shriharivish/Biomon_Photoplethysmography/README.md

# Biomon_Photoplethysmography
Design of the control circuit for the osram biomon sfh 7050 for optical photoplethysmography

For more insight about the project, the design and understanding what was done and why see the PDF named as final report.
