shriharivish/Biomon_Photoplethysmography/Plots/Bandpass1Hz.PNG

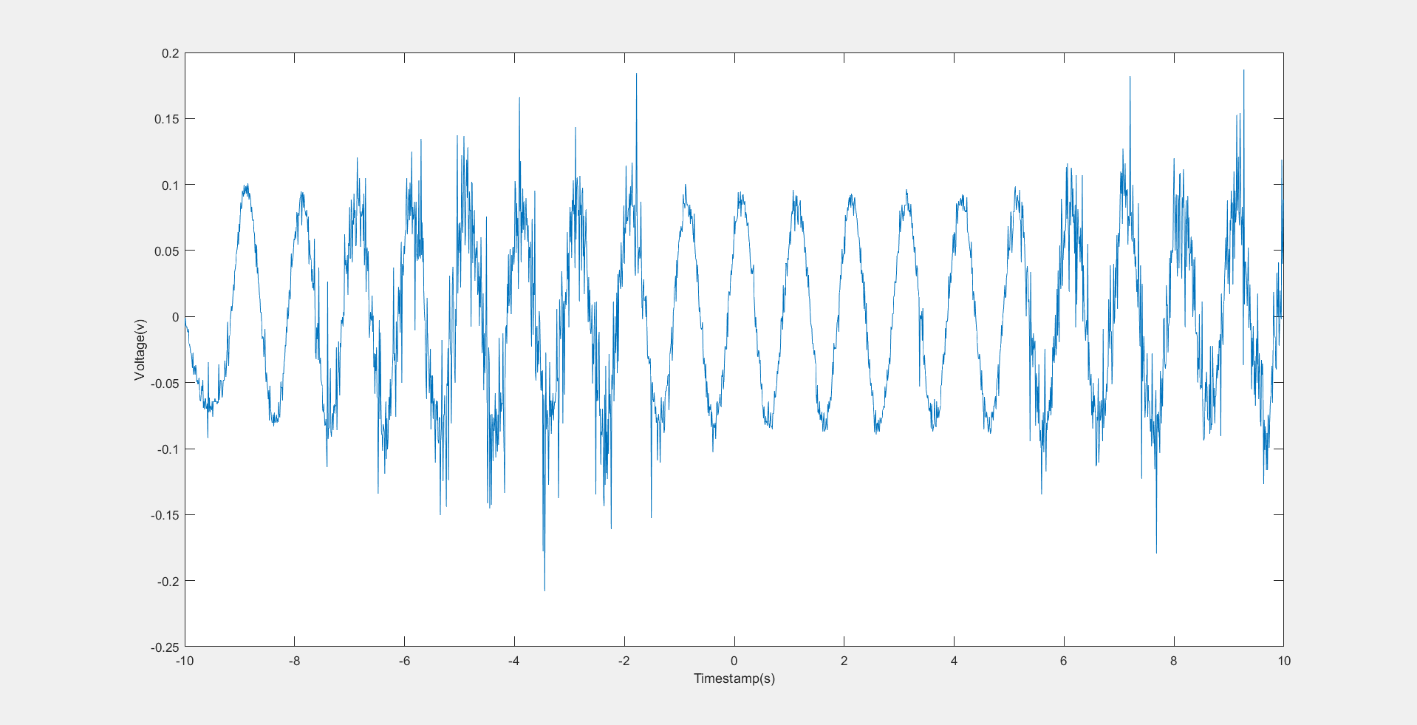
Plots/Bandpass1Hz.PNG
