shriharivish/Biomon_Photoplethysmography/Plots/Bandpass5Hz.PNG

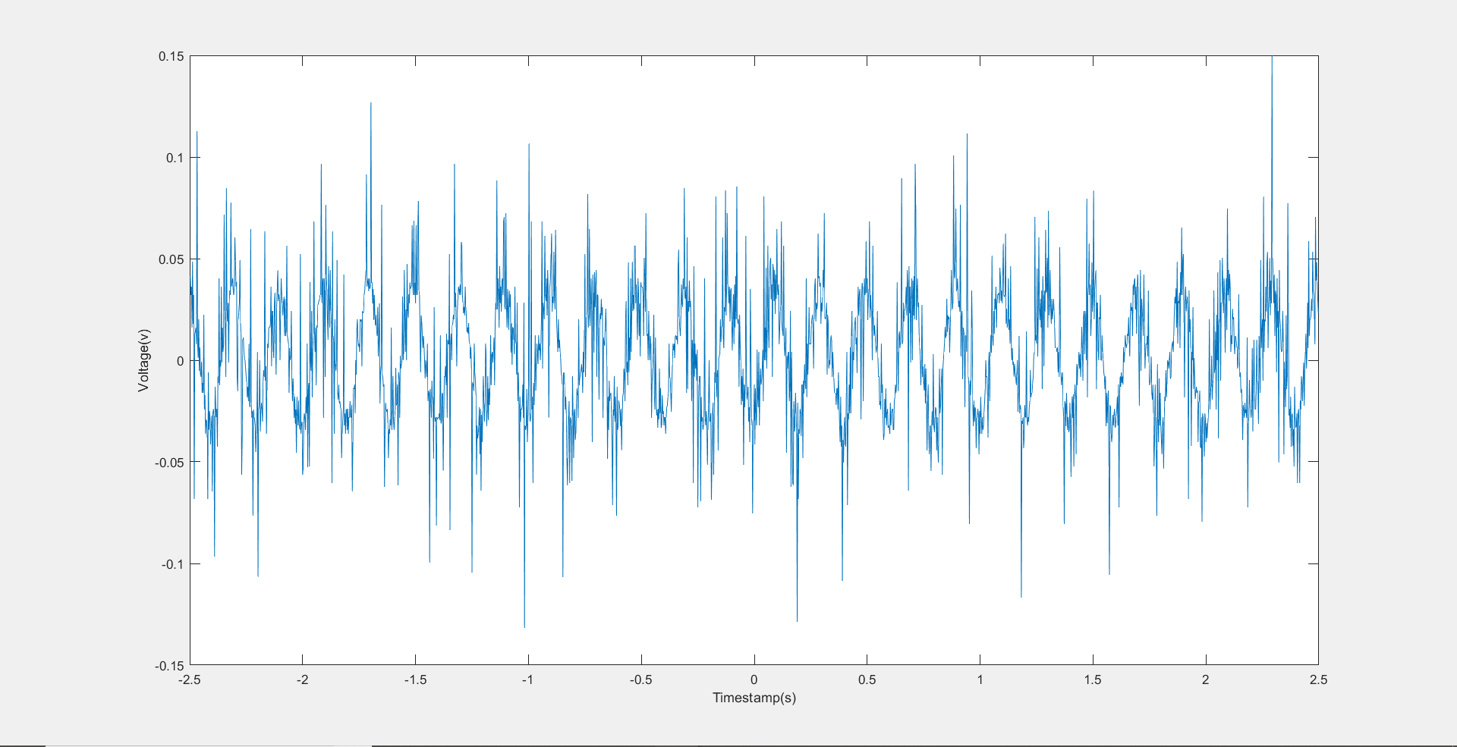
Plots/Bandpass5Hz.PNG
