shriharivish/Biomon_Photoplethysmography/Plots/Bandpass50Hz.PNG

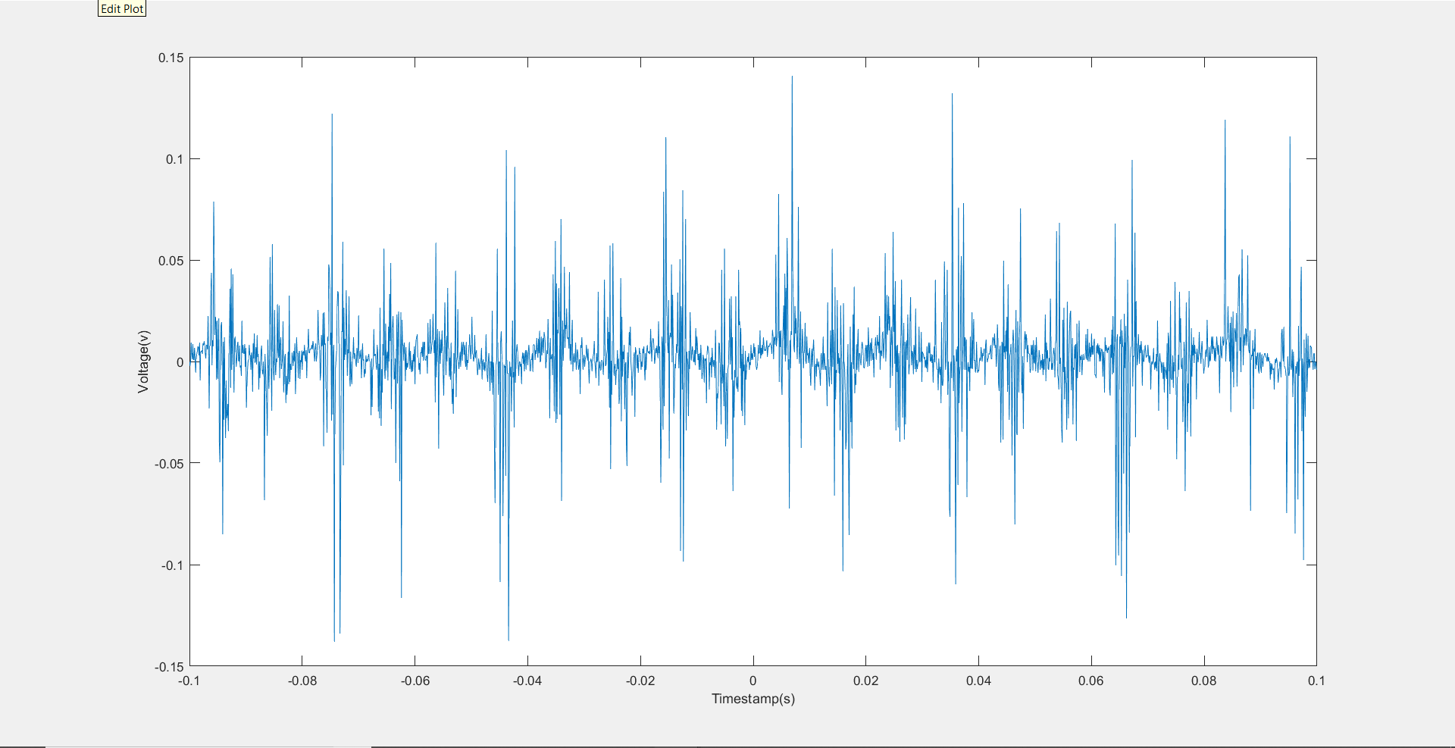
Plots/Bandpass50Hz.PNG
