shriharivish/Biomon_Photoplethysmography/Plots/FilteredAndRaw.PNG

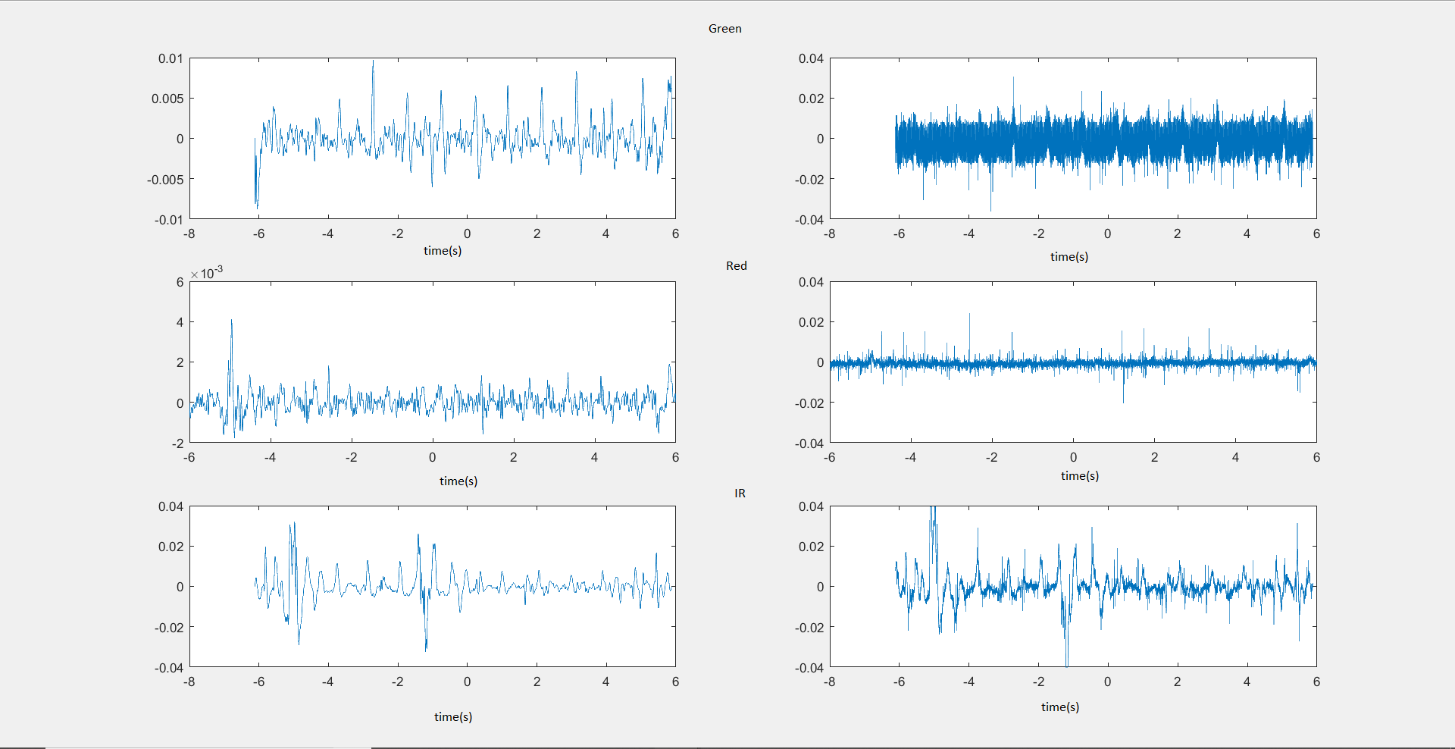
Plots/FilteredAndRaw.PNG
