shriharivish/Biomon_Photoplethysmography/Plots/Notch.PNG

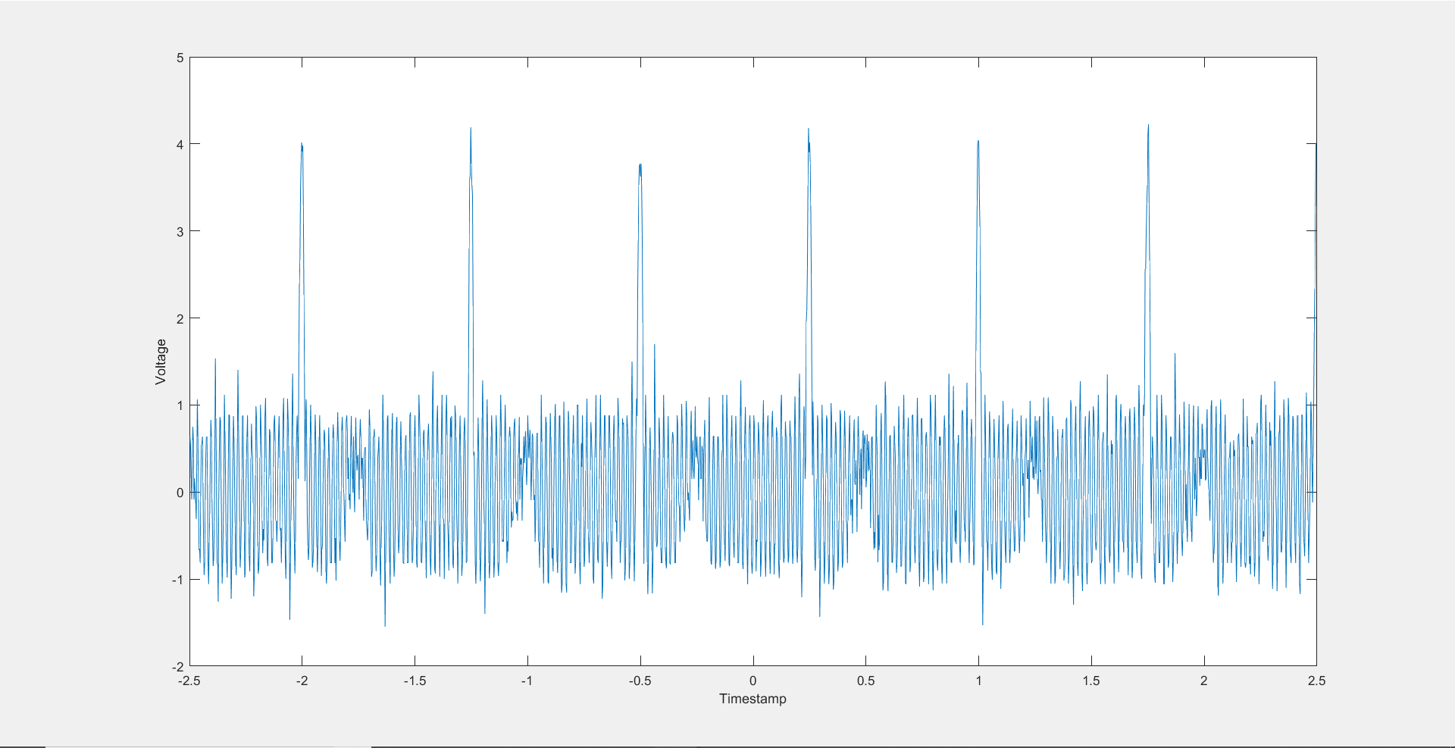
Plots/Notch.PNG
