shriharivish/Biomon_Photoplethysmography/2ndOrderButterworth.asc

C1: cap; 470n
C2: cap; 470n
C3: cap; 470n
C4: cap; 470n
R1: res; 42.3k
R2: res; 42.3k
R3: res; 1.69Meg
R4: res; 1.69Meg
U1: opamp2; UA741
U2: opamp2; UA741
V1: voltage; 15
V2: voltage; 15
V3: voltage; SINE(0 1 1); AC 1
Named nets: VCC, VEE, 0
.include UA741.txt
.include LMV793.txt
.ac dec 4 10m 10k
