shriharivish/Biomon_Photoplethysmography/5thOrderButterworth.asc

C1: cap; 10n
C2: cap; 10n
C3: cap; 10n
C4: cap; 10n
R1: res; 18.32Meg
R2: res; 36.64Meg
R3: res; 18.32Meg
R4: res; 34Meg
R5: res; 17Meg
R6: res; 17Meg
R7: res; 5k
R8: res; 5k
R9: res; 10k
R10: res; 10k
U1: opamp2; UA741
U4: opamp2; UA741
V1: voltage; 5
V3: voltage; 5
V4: voltage; SINE(0 1 1); AC 1
Named nets: VCC, VEE, 0
.include UA741.txt
.include LMV793.txt
.ac dec 4 10m 100meg
