shriharivish/Biomon_Photoplethysmography/Bandstop-wein.asc

C1: cap; 1n
C2: cap; 1n
R1: res; 1Meg
R2: res; 11.2k
R3: res; 11.1k
R4: res; 3.18Meg
R5: res; 1Meg
R6: res; 2Meg
R7: res; 3.18Meg
U1: opamp2; UA741
U2: opamp2; UA741
V1: voltage; 5
V2: voltage; 5
V3: voltage; SINE(); AC 1
Named nets: VCC, VEE, 0
.include UA741.txt
.include LMV793.txt
.ac dec 4 10m 10k
