shriharivish/Biomon_Photoplethysmography/Bandstop.asc

C1: cap; 10n
C2: cap; 10n
C3: cap; 20n
R1: res; 318.3k
R2: res; 318.3k
R3: res; 159.2k
R4: res; 10k
R5: res; 99k
U1: opamp2; UA741
U2: opamp2; UA741
V1: voltage; 5
V2: voltage; 5
V3: voltage; SINE(); AC 1
Named nets: VCC, VEE, 0
.include UA741.txt
.include LMV793.txt
.ac dec 4 10m 10k
