shriharivish/Biomon_Photoplethysmography/Cascaded sallen key.asc

C1: cap; 32µ
C2: cap; 32µ
C3: cap; 0.5µ
C4: cap; 0.5µ
R1: res; 10k
R2: res; 10k
R3: res; 10k
R5: res; 10k
U1: UniversalOpamp2
U2: UniversalOpamp2
V1: voltage; SINE(); AC 1m
V2: voltage; 5
V3: voltage; 5
Named nets: 0, out, in, out2
.ac oct 10 10m 10k
