shriharivish/Biomon_Photoplethysmography/Draft1.asc

C1: cap; 0.301µ
C2: cap; 9.6µ
C3: cap; 0.07375p
I11: current; PULSE(0 100n 0.1 0.4 0.4 0.1 1); AC 1 0
R1: res; 33k
R2: res; 33k
R3: res; 10Meg
U1: opamp2; LMV793
U2: opamp2; UA741
V1: voltage; 5
V2: voltage; 5
V3: voltage; 5
Named nets: 0, VEE, VDD, VCC
.include UA741.txt
.include LMV793.txt
.ac dec 4 10m 10meg
