shriharivish/Biomon_Photoplethysmography/Draft2.asc

C1: cap; 470n
C2: cap; 470n
C3: cap; 2.2p
C4: cap; 470n
C5: cap; 470n
C6: cap; 470n
C7: cap; 470n
I11: current; PULSE(0 100n 0.1 0.4 0.4 0.1 1); AC 1 0
R1: res; 47k
R2: res; 1.69Meg
R3: res; 10k
R4: res; 6.8k
R5: res; 6.8k
R6: res; 6.8k
R7: res; 6.8k
U1: opamp2; LMV793
U2: opamp2; UA741
V1: voltage; 5
V2: voltage; 5
V3: voltage; 5
Named nets: 0, VEE, VDD, VCC
.include UA741.txt
.include LMV793.txt
.ac dec 8 0.01 1k
